talexone/tubpi/plan.md

# Plan de développement - Caméra sur rail pilotée par Raspberry Pi 5

## 1) Définir le besoin
- Objectif principal : déplacer une caméra le long d’un rail automatiquement.
- Fonctions clés : contrôle de vitesse, positionnement précis, arrêt/retour, commande à distance ou via interface web.
- Contraintes : compatibilité avec Raspberry Pi 5, alimentation, sécurité, stabilité du rail.

## 2) Choisir le matériel
- Raspberry Pi 5 ou 3b
- Carte `RPI Motor Driver Board`
- Moteur DC ou pas à pas adapté au système de rail
- Capteurs de fin de course / capteurs de position (fortement recommandé)
- Caméra compatible Raspberry Pi (par exemple `Raspberry Pi Camera Module`)
- Alimentation stable pour le Pi et le moteur
- Châssis / rail, supports, courroie ou engrenage selon la mécanique

## 3) Concevoir l’architecture
- Module motorisation : `RPI Motor Driver Board` pilotant le moteur via GPIO ou interface dédiée
- Module caméra : `libcamera` ou `picamera` côté Raspberry Pi
- Logiciel de commande :
  - gestion des mouvements avant/arrière
  - API ou interface web
  - gestion des limites et sécurité moteur
- Interface utilisateur :
  - interface web simple (Flask, FastAPI)
  - ou commandes SSH/locales
  - visualisation en direct de la caméra (stream)

## 4) Prototyper l’électronique
- Connecter le driver moteur au Raspberry Pi
- Vérifier les broches utilisées (GPIO, PWM, alimentation)
- Tester un mouvement de base : sens avant/arrière, marche/arrêt
- Ajouter des capteurs de fin de course pour prévenir les débordements

## 5) Développer le logiciel
- Installer l’OS et les dépendances sur le Raspberry Pi 5
- Écrire un pilote de base pour la carte motor driver
- Créer des fonctions :
  - `move_forward(distance/vitesse)`
  - `move_backward(...)`
  - `stop()`
  - `home()` ou `calibrate()`
- Implémenter la capture vidéo de la caméra
- Ajouter l’interface utilisateur (web ou console)

## 6) Tester et itérer
- Tester chaque élément séparément :
  - commande moteur
  - lecture des capteurs
  - flux caméra
- Tester le système intégré sur le rail
- Ajuster la vitesse, les accélérations, la précision
- Valider la sécurité et les arrêts d’urgence

## 7) Finaliser et documenter
- Documenter l’assemblage matériel
- Documenter l’installation logicielle
- Créer un guide d’utilisation
- Prévoir des améliorations futures :
  - mouvement automatique programmé
  - suivi d’objet
  - contrôle par smartphone

> Résultat attendu : un système fonctionnel où la caméra se déplace sur rail via Raspberry Pi 5, contrôlé par un logiciel fiable et sécurisé.
