talexone/tubpi/docs/aux_board/aux_board.kicad_sch

## KiCad design docs/aux_board/aux_board.kicad_sch (2026-04-24)

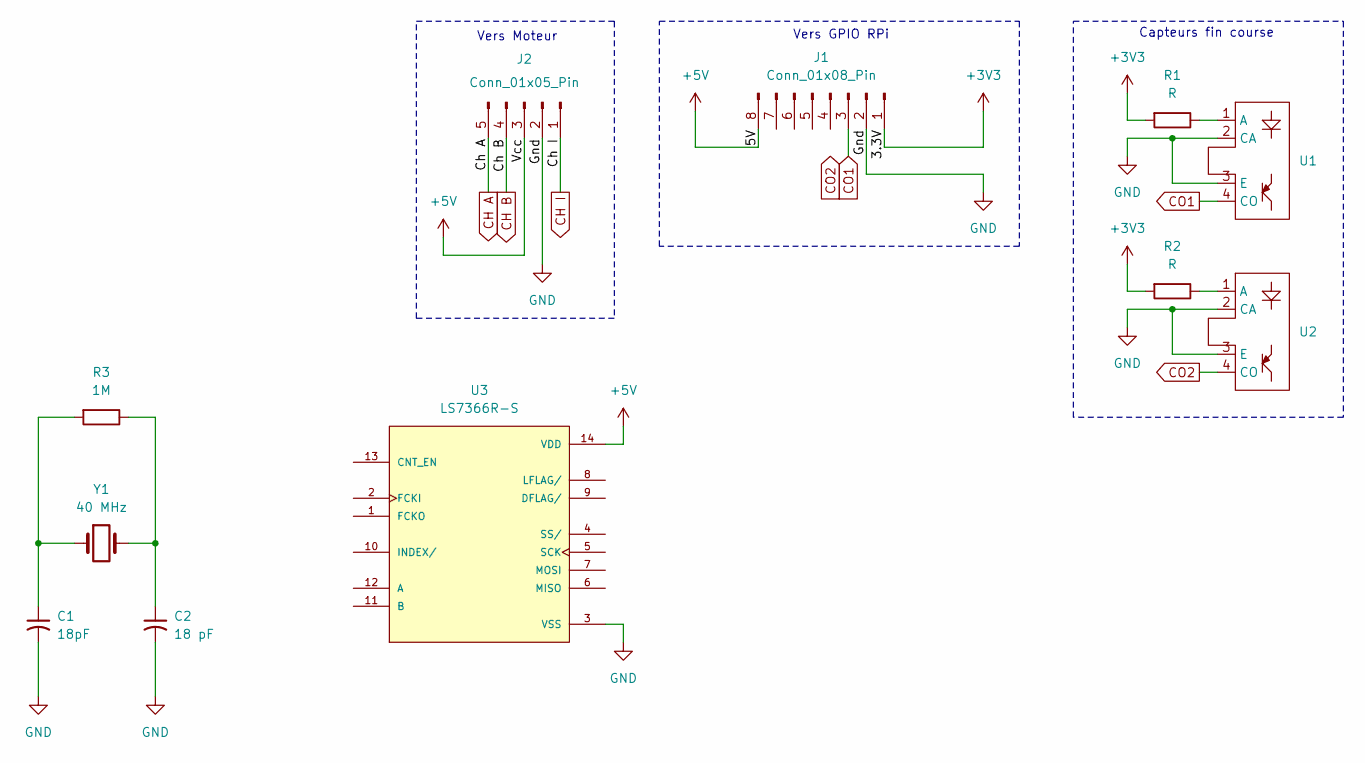
[picture p1: schematic aux_board.kicad_sch]

Parts:
C1: 18pF
C2: 18 pF
J1: Conn_01x08_Pin
J2: Conn_01x05_Pin
R1, R2: R
R3: 1M
U1, U2: (no value)
U3: LS7366R-S; SOIC127P600X175-14N
Y1: 40 MHz

Connections:
+3V3: J1.1, R1.2, R2.2
+5V: J1.8, J2.3, U3.14 (VDD)
CH A: J2.5
CH B: J2.4
CH I: J2.1
CO1: J1.3, U1.4 (CO)
CO2: U2.4 (CO)
Gnd: C1.2, C2.2, J1.2, J2.2, U1.2 (CA), U1.3 (E), U2.2 (CA), U2.3 (E), U3.3 (VSS)
unnamed: C1.1, R3.2, Y1.1
unnamed: C2.1, R3.1, Y1.2
unnamed: R1.1, U1.1 (A)
unnamed: R2.1, U2.1 (A)

Notes on the sheet:
Vers Moteur
Capteurs fin course
Vers GPIO RPi
