talexone/tubpi/(commit log)

2026-04-13 test motor
2026-04-23 latence encoder
    [aux_board.kicad_sch]
2026-04-23 feat: Add pigpio GPIO driver implementation
    - Add motor_driver_pigpio.py with full pigpio support
    - Update requirements.txt for pigpio dependency
    - Add install_services_pigpio.sh with pigpio configuration
    - Add comprehensive pigpio migration documentation
    - Supports all Raspberry Pi models (1, 2, 3, 4, 5)
    - Better PWM performance and encoder handling
    - Requires pigpiod daemon running
2026-04-24 webapp error
    [aux_board.kicad_sch]
2026-04-27 fix: Add GPIO permissions support for Raspberry Pi 5 on main branch
    - Add DeviceAllow directives to tubpi-webapp.service for /dev/gpiochip* access
    - Add 99-gpio.rules udev configuration for automatic GPIO permissions
    - Add diagnose_gpio.sh diagnostic script for troubleshooting
    - Update install_services.sh to configure udev rules and device permissions
    - Add docs/fix-webapp-gpio.md quick fix guide
    Fixes 'GPIO not allocated' error when webapp service runs as non-root user on Pi 5
2026-04-27 fix: Add initial=GPIO.LOW to prevent rpi-lgpio allocation error on Pi 5
    rpi-lgpio on Raspberry Pi 5 tries to read GPIO state before allocation
    when initial= is not specified, causing 'GPIO not allocated' error.
    Explicitly setting initial=GPIO.LOW fixes this issue.
    [motor_driver.py]
2026-04-27 fix: Handle GPIO busy gracefully when onvif-gateway owns motor
    When onvif-gateway service (running as root) already owns the GPIO,
    webapp service gets 'GPIO busy' error. Instead of returning 503 error,
    now returns 200 with informative message that motor control is handled
    by onvif-gateway service.
    This allows both services to run simultaneously:
    - onvif-gateway: handles motor control and ONVIF proxy
    - webapp: provides web interface and monitoring (read-only)
    [web_app.py]
2026-04-27 security: Move camera credentials to external config file
    - Remove hardcoded username/password from onvif_gateway.py
    - Add load_camera_credentials() function to read from /opt/tubpi/camera.res
    - Create camera.res.example as template
    - Update install_services.sh to prompt for credentials during installation
    - Add camera.res to .gitignore to prevent credential leaks
    - Add docs/camera-config.md with configuration guide
    - File permissions: 600 (root only) for security
    Format of camera.res:
    user=<username>
    password=<password>
    [onvif_gateway.py]
2026-04-27 feat: Add motor status API endpoints to onvif-gateway for webapp display
    onvif-gateway now exposes REST API endpoints:
    - GET /api/motor/status - Returns motor state, limit switches, encoder stats
    - GET /api/motor/encoder - Returns detailed encoder information
    web_app.py updated to:
    - Fetch motor/encoder data from onvif-gateway API when GPIO not available
    - Display real-time sensor and counter info even when motor is managed by onvif-gateway
    - Add 'source' field to indicate data origin (local vs onvif-gateway)
    This allows the webapp (port 5000) to display live motor stats even when
    onvif-gateway (port 80) owns the GPIO. The existing HTML template already
    polls /status endpoint, so it will a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
2026-04-27 fix: Enable motor control buttons in webapp when GPIO owned by onvif-gateway
    Added POST /api/motor/move endpoint to onvif-gateway that accepts:
    - forward, backward, stop, calibrate commands
    Modified web_app.py /move endpoint to:
    - Remove before_request blocker that returned 503 when motor unavailable
    - Delegate motor commands to onvif-gateway API when GPIO not available locally
    - Use local motor when available
    - Add 'source' field to responses (local vs onvif-gateway)
    Now the webapp direction buttons work in both scenarios:
    1. Webapp has GPIO access -> controls motor directly (source: local)
    2. onvif-gateway owns GPIO -> sends commands via API (source: onvif-gateway)
    Fixes: Direction butt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
    [onvif_gateway.py, web_app.py]
2026-04-27 feat: Add step movement buttons with auto-stop after 1 second
    Added new step movement controls to webapp:
    - Two new buttons: 'Pas avant' (step forward) and 'Pas arrière' (step backward)
    - Buttons start movement, wait 1 second, then automatically stop
    - Visual feedback: buttons disabled during operation with pulse animation
    - Separated continuous movement controls from step controls with section headers
    UI improvements:
    - Added h3 section headers to organize controls
    - Step buttons styled in purple to distinguish from continuous movement
    - Hover effects and disabled state for better UX
    - Active animation during step operation
    JavaScript:
    - sendMoveStep() function handles the step sequence: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
2026-04-27 feat: Add integrated RTSP video player on main page
    Added RTSP video player directly on the same page as control buttons:
    - Video player container with 16:9 aspect ratio
    - Dark theme panel to distinguish from controls
    - RTSP URL display (rtsp://192.168.66.212:554/)
    - Copy to clipboard button for RTSP URL
    - Direct VLC launcher link (vlc://)
    - Warning note explaining RTSP requires VLC
    UI changes:
    - Video panel placed at top of page before controls
    - Styled with dark background (#1a1a1a) for video context
    - Info panel shows RTSP URL with quick actions
    - Note explains browsers don't support RTSP natively
    User experience:
    - Click 'Copier' to copy RTSP URL
    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
2026-04-27 feat: Update RTSP URL with full authentication path
    Updated RTSP configuration to use complete camera URL format:
    - Format: rtsp://user:password@ip:554/cam/realmonitor?channel=1&subtype=1
    - Added /camera/rtsp-url endpoint that reads credentials from camera.res
    - Constructs full RTSP URL with authentication
    - Returns display URL with masked password (user:*****@...)
    Frontend changes:
    - Loads RTSP URL dynamically on page load via API
    - Updates video source and VLC link with credentials
    - Displays URL with masked password for security
    - Copies full URL with password when clicking Copy button
    Camera configuration:
    - IP: 192.168.1.108 (direct camera access)
    - Port: 554
    - Path: /cam/realmonitor?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
2026-04-28 fix: Change camera.res permissions to allow webapp access
    Changed camera.res file permissions from 600 (root only) to 640 (root + group):
    - Owner: root (read/write)
    - Group: dietpi (read only)
    - Others: no access
    This allows:
    - tubpi-onvif-gateway (runs as root) to read credentials
    - tubpi-webapp (runs as dietpi) to read credentials for RTSP URL endpoint
    Updated files:
    - install_services.sh: Sets chmod 640 and chown root:dietpi
    - docs/camera-config.md: Updated documentation with new permissions
    Fixes: Permission denied error when webapp tries to read camera.res
    Error was: [Errno 13] Permission denied: '/opt/tubpi/camera.res'
    To fix on existing installations:
    sudo chmod 640 /opt/tubpi/cam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
2026-04-28 feat: Intégration MediaMTX pour streaming WebRTC
    - Modification de test.html pour utiliser MediaMTX (déjà installé sur RPi)
    - Ajout de la connexion WebRTC via protocole WHEP
    - Affichage du flux caméra directement dans le navigateur
    - Gestion de la reconnexion automatique en cas d'erreur
    - Ajout de la documentation MediaMTX (mediamtx-setup.md)
    - Conservation de l'option RTSP pour VLC en alternatif
    MediaMTX écoute sur le port 8889 et expose le flux 'ma_camera' en WebRTC.
    La webapp se connecte automatiquement au démarrage de la page.
2026-04-28 config: Exécuter tubpi-webapp en tant que root
    - Change User=pi à User=root
    - Change Group=gpio à Group=root
    - Permet un accès direct au GPIO sans délégation
2026-04-28 feat: Ajouter option pour désactiver les capteurs de fin de course
    - motor_driver.py: Ajout paramètre enable_limit_switches et méthodes set/get
    - web_app.py: Endpoint /limit_switches avec délégation à onvif-gateway
    - onvif_gateway.py: Endpoint API /api/motor/limit_switches
    - test.html: Checkbox pour activer/désactiver les capteurs
    - get_limit_switches_status() retourne maintenant l'état enabled
    - Interface utilisateur avec notification visuelle du changement d'état
    Permet de désactiver temporairement les capteurs de fin de course
    pour les tests ou la maintenance sans modifier le matériel.
2026-04-28 feat: Ajouter service MediaMTX dans /opt/mediamtx/
    - systemd/mediamtx.service: Service systemd pour MediaMTX
    - update_mediamtx_config.sh: Script de génération de config depuis camera.res
    - install_mediamtx.sh: Script d'installation automatique
    - docs/mediamtx-setup.md: Documentation mise à jour
    MediaMTX s'installe dans /opt/mediamtx/ avec:
    - Détection automatique de l'architecture (ARM64/ARM/x86_64)
    - Configuration générée depuis /opt/tubpi/camera.res
    - Service systemd avec ExecStartPre pour mise à jour config
    - Deux flux: ma_camera (qualité moyenne) et ma_camera_hq (haute qualité)
    - API et WebRTC sur port 8889
2026-04-28 fix: Séparer les ports API (9997) et WebRTC (8889) dans MediaMTX
    Le conflit 'address already in use' sur le port 8889 était causé par
    l'API et WebRTC qui tentaient tous deux d'utiliser le même port.
    Changements:
    - API MediaMTX: port 9997 (défaut MediaMTX)
    - WebRTC: port 8889 (inchangé)
    - Documentation mise à jour avec les bons ports
2026-04-28 fix: Inverser la logique des capteurs de fin de course
    - Changement de LOW = déclenché à HIGH = déclenché
    - Les capteurs optiques retournent HIGH quand le faisceau est coupé
    - Les fonctions _is_limit_forward_triggered() et _is_limit_backward_triggered() utilisent maintenant GPIO.HIGH au lieu de GPIO.LOW
    [motor_driver.py]
2026-04-28 feat: Ajouter détection de défaillance du driver moteur (GPIO 16)
    - Ajout du paramètre motor_fail_pin (GPIO 16, défaut)
    - Nouvelle méthode _is_motor_driver_failed() pour vérifier le signal de fail
    - Vérification pendant la rampe PWM (_ramp_up) pour arrêt d'urgence
    - get_limit_switches_status() retourne maintenant motor_driver_fail
    - can_move_forward/backward vérifient l'état du driver avant mouvement
    - Interface web affiche l'état du driver moteur (OK / DÉFAILLANCE)
    - LOW sur GPIO 16 = défaillance (surchauffe, court-circuit, etc.)
    [motor_driver.py]
2026-04-28 refactor: Nettoyer le code JavaScript WebRTC
    - Supprimer les références à l'élément 'webrtc-url' qui n'existe plus dans le HTML
    - La page affiche uniquement le statut de connexion WebRTC sans URLs
    - Les erreurs sont loggées dans la console au lieu de modifier l'UI
2026-04-30 motor datasheet
2026-04-30 fix: Changer le pin Motor Fail de GPIO 16 à GPIO 18
    - Modifier motor_driver.py pour utiliser GPIO 18 par défaut
    - Mettre à jour la documentation hardware.md avec le nouveau pin
    - GPIO 18 : signal de défaillance du driver moteur (LOW = défaillance)
    [motor_driver.py]
2026-05-01 feat: Ajouter checkbox pour activer/désactiver l'encodeur
    - Ajouter set_encoder_enabled() et get_encoder_enabled() dans motor_driver.py
    - Ajouter/supprimer les interruptions GPIO dynamiquement lors du changement d'état
    - Ajouter endpoint POST /encoder dans web_app.py
    - Ajouter endpoint POST /api/motor/encoder dans onvif_gateway.py
    - Ajouter checkbox 'Activer l'encodeur de position' dans test.html
    - Ajouter fonction toggleEncoder() pour gérer les changements
    - Inclure l'état 'enabled' dans get_encoder_stats()
    - Mise à jour automatique de la checkbox depuis l'API
